pavkriz/zx-uniper/doc/zx-uniper-stm32f7.png

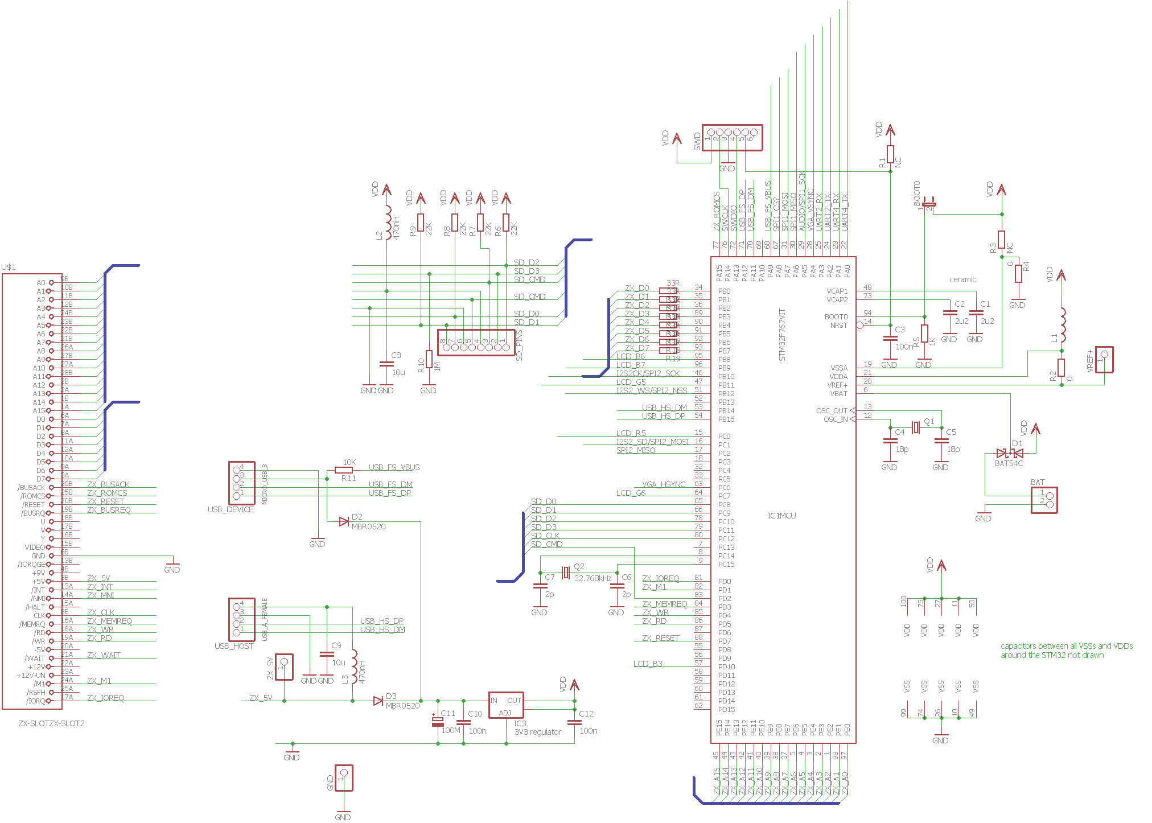
doc/zx-uniper-stm32f7.png
