pavkriz/zx-uniper/doc/zx-uniper-stm32f7.sch

## EAGLE design doc/zx-uniper-stm32f7.sch (2016-10-03)

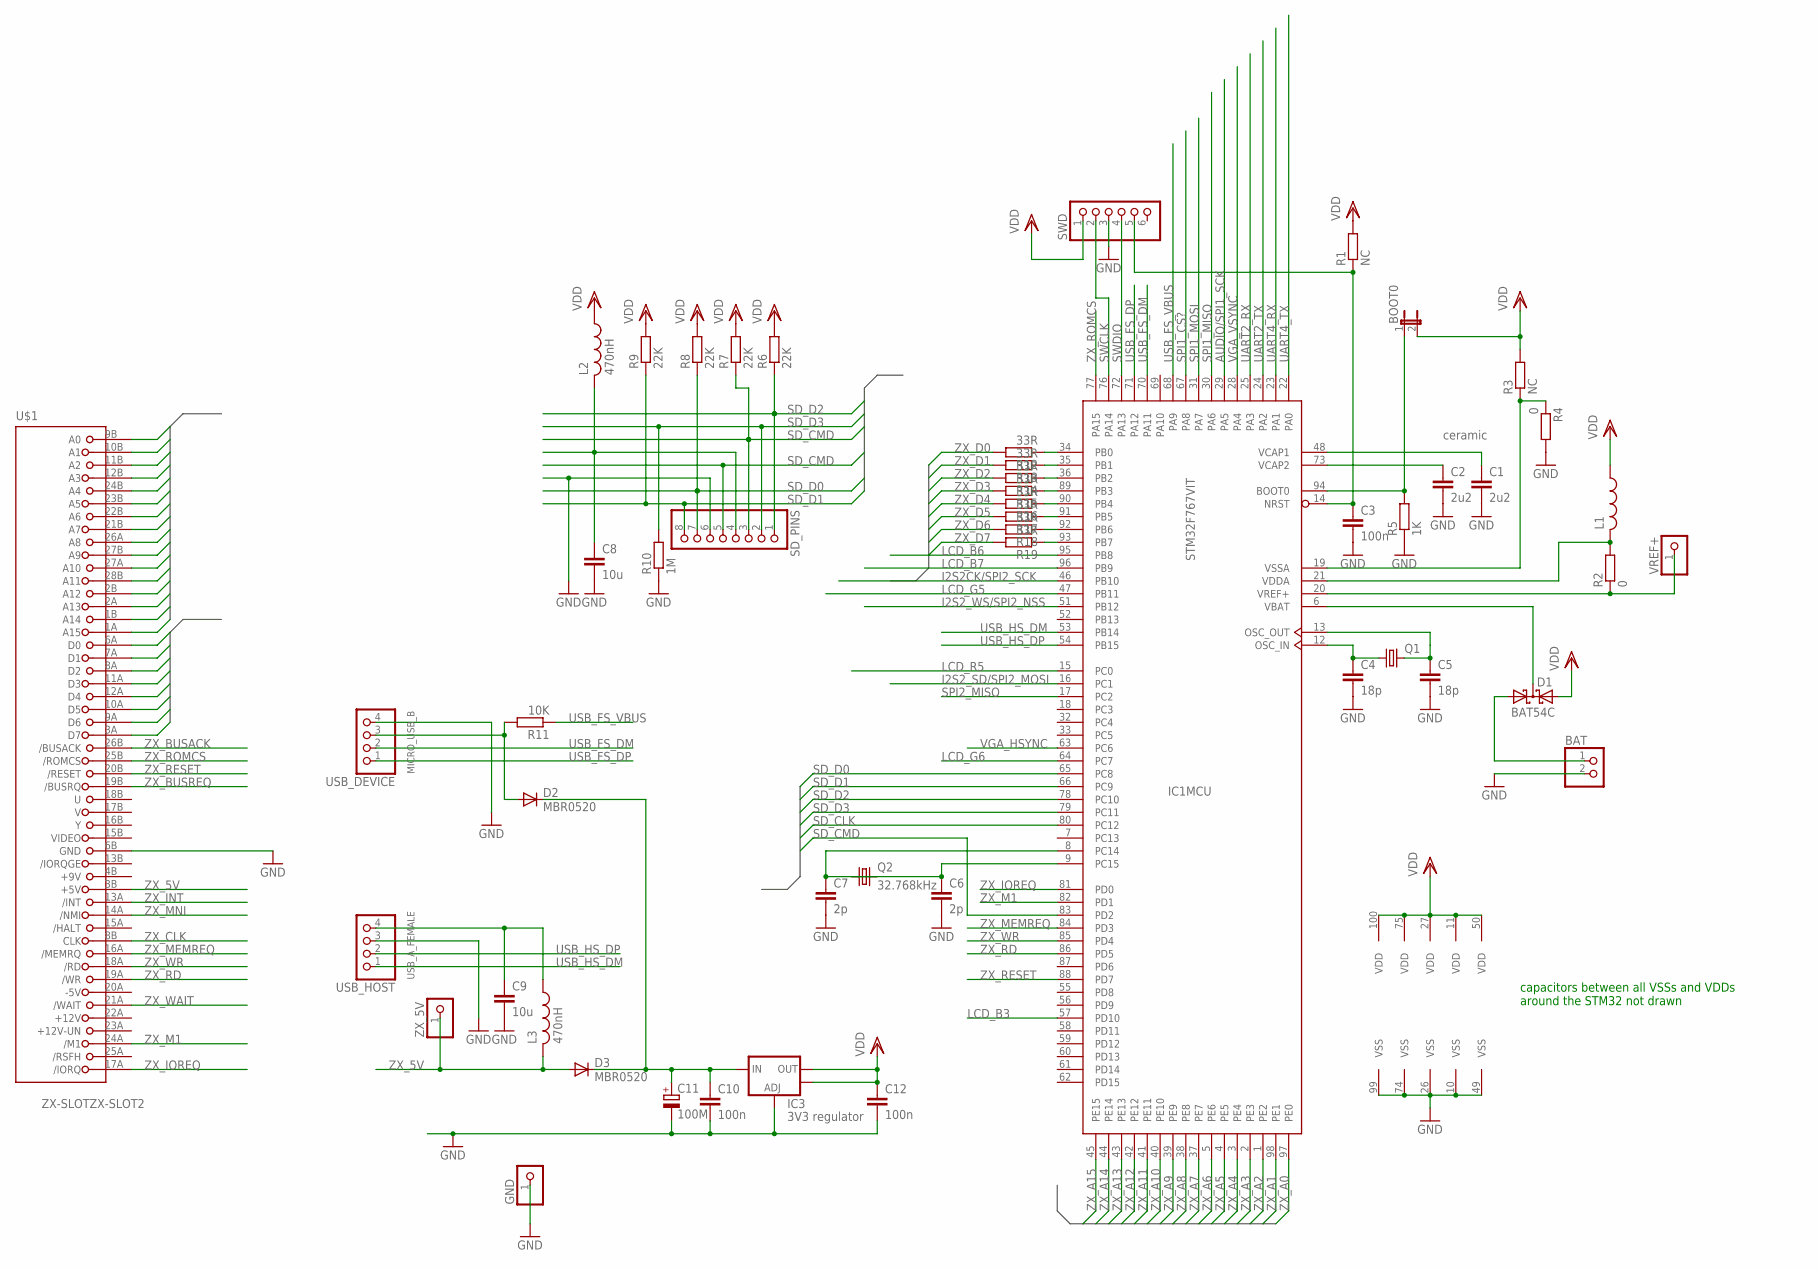
[picture p2: schematic zx-uniper-stm32f7.sch]

Parts:
BAT: PINHD-1X2; 1X02
BOOT0: JP1E; JP1
C1, C2: 2u2; C0504
C3, C10, C12: 100n; C0504
C4, C5: 18p; C0504
C6, C7: 2p; C0504
C8, C9: 10u; C0504
C11: 100M; PANASONIC_E
D1: BAT54C; SOT23
D2, D3: MBR0520; SOD123
GND: PINHD-1X1; 1X01
IC1: STM32F767VIT; LQFP100
IC3: 3V3 regulator; SOT223
L1: L-USL3225P; L3225P
L2, L3: 470nH; L3225P
Q1: CRYSTALSM49; SM49
Q2: 32.768kHz; TC38H
R1, R3: NC; R0805
R2, R4: 0; R0805
R5: 1K; R0805
R6, R7, R8, R9: 22K; R0805
R10: 1M; R0805
R11: 10K; R0805
R12, R13, R14, R15, R16, R17, R18, R19: 33R; R0805
SD_PINS: PINHD-1X8; 1X08
SWD: PINHD-1X6; 1X06
U$1: ZX-SLOTZX-SLOT2; ZXCONECT2
USB_DEVICE: PINHD-1X4; 1X04
USB_HOST: PINHD-1X4; 1X04
VREF+: PINHD-1X1; 1X01
ZX_5V: PINHD-1X1; 1X01

Connections:
AUDIO/SPI1_SCK: IC1.29 (PA5)
GND: BAT.2, C1.2, C2.2, C3.2, C4.2, C5.2, C6.2, C7.2, C8.2, C9.2, C10.2, C11.-, C12.2, GND.1, IC1.10 (VSS), IC1.26 (VSS), IC1.49 (VSS), IC1.74 (VSS), IC1.99 (VSS), IC3.1 (ADJ), R4.2, R5.1, R10.1, SD_PINS.6, SWD.3, U$1.6B (GND), USB_DEVICE.4, USB_HOST.3
I2S2CK/SPI2_SCK: IC1.46 (PB10)
I2S2_SD/SPI2_MOSI: IC1.16 (PC1)
I2S2_WS/SPI2_NSS: IC1.51 (PB12)
LCD_B3: IC1.57 (PD10)
LCD_B6: IC1.95 (PB8)
LCD_B7: IC1.96 (PB9)
LCD_G5: IC1.47 (PB11)
LCD_G6: IC1.64 (PC7)
LCD_R5: IC1.15 (PC0)
unnamed: IC1.20 (VREF+), R2.1, VREF+.1
unnamed: IC1.21 (VDDA), L1.2, R2.2
unnamed: C1.1, IC1.48 (VCAP1)
unnamed: C2.1, IC1.73 (VCAP2)
unnamed: IC1.19 (VSSA), R3.1, R4.1
unnamed: BOOT0.1, IC1.94 (BOOT0), R5.2
unnamed: C4.1, IC1.12 (OSC_IN), Q1.1
unnamed: C5.1, IC1.13 (OSC_OUT), Q1.2
unnamed: C6.1, IC1.9 (PC15), Q2.1
unnamed: C7.1, IC1.8 (PC14), Q2.2
unnamed: D1.3 (CC), IC1.6 (VBAT)
unnamed: BAT.1, D1.1 (A1)
unnamed: C8.1, L2.2, SD_PINS.4
unnamed: C10.1, C11.+, D2.C, D3.C, IC3.3 (IN)
unnamed: IC1.34 (PB0), R12.1
unnamed: IC1.35 (PB1), R13.1
unnamed: IC1.36 (PB2), R14.1
unnamed: IC1.89 (PB3), R15.1
unnamed: IC1.90 (PB4), R16.1
unnamed: IC1.91 (PB5), R17.1
unnamed: IC1.92 (PB6), R18.1
unnamed: IC1.93 (PB7), R19.1
NRST: C3.1, IC1.14 (NRST), R1.1, SWD.5
SD_CLK: IC1.80 (PC12), SD_PINS.5
SD_CMD: IC1.83 (PD2), R7.1, SD_PINS.3
SD_D0: IC1.65 (PC8), R8.1, SD_PINS.7
SD_D1: IC1.66 (PC9), R9.1, SD_PINS.8
SD_D2: IC1.78 (PC10), R6.1, SD_PINS.1
SD_D3: IC1.79 (PC11), R10.2, SD_PINS.2
SPI1_CS?: IC1.67 (PA8)
SPI1_MISO: IC1.30 (PA6)
SPI1_MOSI: IC1.31 (PA7)
SPI2_MISO: IC1.17 (PC2)
SWCLK: IC1.76 (PA14), SWD.2
SWDIO: IC1.72 (PA13), SWD.4
UART2_RX: IC1.25 (PA3)
UART2_TX: IC1.24 (PA2)
UART4_RX: IC1.23 (PA1)
UART4_TX: IC1.22 (PA0)
USB0_VBUS_RAW: D2.A, R11.2, USB_DEVICE.3
USB_FS_DM: IC1.70 (PA11), USB_DEVICE.2
USB_FS_DP: IC1.71 (PA12), USB_DEVICE.1
USB_FS_VBUS: IC1.68 (PA9), R11.1
USB_HOST_5V: C9.1, L3.1, USB_HOST.4
USB_HS_DM: IC1.53 (PB14), USB_HOST.1
USB_HS_DP: IC1.54 (PB15), USB_HOST.2
VDD: BOOT0.2, C12.1, D1.2 (A2), IC1.11 (VDD), IC1.27 (VDD), IC1.50 (VDD), IC1.75 (VDD), IC1.100 (VDD), IC3.2 (OUT), IC3.4 (OUT), L1.1, L2.1, R1.2, R3.2, R6.2, R7.2, R8.2, R9.2, SWD.1
VGA_HSYNC: IC1.63 (PC6)
VGA_VSYNC: IC1.28 (PA4)
ZX_5V: D3.A, L3.2, U$1.3B (+5V), ZX_5V.1
ZX_A0: IC1.97 (PE0), U$1.9B (A0)
ZX_A1: IC1.98 (PE1), U$1.10B (A1)
ZX_A2: IC1.1 (PE2), U$1.11B (A2)
ZX_A3: IC1.2 (PE3), U$1.12B (A3)
ZX_A4: IC1.3 (PE4), U$1.24B (A4)
ZX_A5: IC1.4 (PE5), U$1.23B (A5)
ZX_A6: IC1.5 (PE6), U$1.22B (A6)
ZX_A7: IC1.37 (PE7), U$1.21B (A7)
ZX_A8: IC1.38 (PE8), U$1.26A (A8)
ZX_A9: IC1.39 (PE9), U$1.27B (A9)
ZX_A10: IC1.40 (PE10), U$1.27A (A10)
ZX_A11: IC1.41 (PE11), U$1.28B (A11)
ZX_A12: IC1.42 (PE12), U$1.2B (A12)
ZX_A13: IC1.43 (PE13), U$1.2A (A13)
ZX_A14: IC1.44 (PE14), U$1.1B (A14)
ZX_A15: IC1.45 (PE15), U$1.1A (A15)
ZX_BUSACK: U$1.26B (/BUSACK)
ZX_BUSREQ: U$1.19B (/BUSRQ)
ZX_CLK: U$1.8B (CLK)
ZX_D0: R12.2, U$1.6A (D0)
ZX_D1: R13.2, U$1.7A (D1)
ZX_D2: R14.2, U$1.8A (D2)
ZX_D3: R15.2, U$1.11A (D3)
ZX_D4: R16.2, U$1.12A (D4)
ZX_D5: R17.2, U$1.10A (D5)
ZX_D6: R18.2, U$1.9A (D6)
ZX_D7: R19.2, U$1.3A (D7)
ZX_INT: U$1.13A (/INT)
ZX_IOREQ: IC1.81 (PD0), U$1.17A (/IORQ)
ZX_M1: IC1.82 (PD1), U$1.24A (/M1)
ZX_MEMREQ: IC1.84 (PD3), U$1.16A (/MEMRQ)
ZX_MNI: U$1.14A (/NMI)
ZX_RD: IC1.86 (PD5), U$1.19A (/WR)
ZX_RESET: IC1.88 (PD7), U$1.20B (/RESET)
ZX_ROMCS: IC1.77 (PA15), U$1.25B (/ROMCS)
ZX_WAIT: U$1.21A (/WAIT)
ZX_WR: IC1.85 (PD4), U$1.18A (/RD)

Notes on the sheet:
ceramic
MICRO_USB_B
USB_A_FEMALE
capacitors between all VSSs and VDDs around the STM32 not drawn
