pavkriz/zx-uniper/Src/main.c

/**
  ******************************************************************************
  * File Name          : main.c
  * Description        : Main program body
  ******************************************************************************
  *
  * Copyright (c) 2017 STMicroelectronics International N.V. 
  * All rights reserved.
  *
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
  ******************************************************************************
  */
/* Includes ------------------------------------------------------------------*/
#include "main.h"
#include "stm32f7xx_hal.h"
#include "usb_device.h"
#include "usb_host.h"

/* USER CODE BEGIN Includes */

#include <zx_rd_wr_interrupt.h>
#include "op_sniff_loop.h"
#include "stm32f7xx_hal_conf.h"
#include "pintest.h"
#include <stdarg.h>
#include "usb_host.h"
#include "usbh_msc.h"
#include "emu_divide_ports.h"
#include "uniper_splash.h"


/* USER CODE END Includes */


SD_HandleTypeDef hsd1;

UART_HandleTypeDef huart4;
UART_HandleTypeDef huart2;

/* USER CODE BEGIN PV */

#define HANG_LOOP() {HAL_GPIO_WritePin(LED1_GPIO_Port, LED1_Pin, GPIO_PIN_SET); while (1) {}}


/* USER CODE END PV */

void SystemClock_Config(void);
void Error_Handler(void);
static void MX_GPIO_Init(void);
static void MX_UART4_Init(void);
static void MX_SDMMC1_SD_Init(void);
static void MX_USART2_UART_Init(void);
void MX_USB_HOST_Process(void);

/* USER CODE BEGIN PFP */

/* USER CODE END PFP */

/* USER CODE BEGIN 0 */

#define UART_LEN 1
uint8_t UART_Rx_data[UART_LEN];
volatile int rx_timeouts = 0;


/* USER CODE END 0 */

int main(void)
{

  /* MCU Configuration----------------------------------------------------------*/

  /* Reset of all peripherals, Initializes the Flash interface and the Systick. */
  HAL_Init();

  /* Configure the system clock */
  SystemClock_Config();

  /* Initialize all configured peripherals */
  MX_GPIO_Init();
  //MX_USB_DEVICE_Init();
  //MX_UART4_Init();
  //MX_SDMMC1_SD_Init();
  MX_USART2_UART_Init();
  MX_USB_HOST_Init();

  /* Infinite loop */
  /* USER CODE BEGIN WHILE */

  uint8_t host_command_buffer[20];
  uint8_t sector_buffer[1024];
  int p;

  UART2_printf("=========== START ===============\r\n");

  int zx_init_done = 0;

  UART2_printf("zx_init_pins start\r\n");
  zx_init_pins();
  uniper_splash_show_boot();
  UART2_printf("zx_init_pins end\r\n");
  zx_init_done = 1;


  int usb_disk_found = 0;
  int led_status = 0;
  // wait for USB disk while flashing LED
  while (!usb_disk_found) {
	  HAL_Delay(5);
	  if (GetUsbHostAppliState() == APPLICATION_READY) {
		  usb_disk_found = 1;
	  } else {
		  led_status = !led_status;
		  if (led_status) {
			  HAL_GPIO_WritePin(LED1_GPIO_Port, LED1_Pin, GPIO_PIN_SET);
		  } else {
			  HAL_GPIO_WritePin(LED1_GPIO_Port, LED1_Pin, GPIO_PIN_RESET);
		  }
	  }
	  MX_USB_HOST_Process();
  }

  HAL_GPIO_WritePin(LED1_GPIO_Port, LED1_Pin, GPIO_PIN_RESET);


  MSC_LUNTypeDef lunInfo;
  MSC_GetLUN0Info(&lunInfo);
  UART2_printf("USB block_number=%d, block_size=%d\r\n", lunInfo.capacity.block_nbr, lunInfo.capacity.block_size);

  int startTick = HAL_GetTick();

  emu_wait_until_boot_done();

  emu_default_start();

  while (1)
  {

	  emu_divide_ports_handle_main_loop();

  /* USER CODE END WHILE */
    MX_USB_HOST_Process();

  /* USER CODE BEGIN 3 */
	  	// __WFI();


  }
  /* USER CODE END 3 */

}

/** System Clock Configuration
*/
void SystemClock_Config(void)
{

  RCC_OscInitTypeDef RCC_OscInitStruct;
  RCC_ClkInitTypeDef RCC_ClkInitStruct;
  RCC_PeriphCLKInitTypeDef PeriphClkInitStruct;

    /**Configure the main internal regulator output voltage 
    */
  __HAL_RCC_PWR_CLK_ENABLE();

  __HAL_PWR_VOLTAGESCALING_CONFIG(PWR_REGULATOR_VOLTAGE_SCALE1);

    /**Initializes the CPU, AHB and APB busses clocks 
    */
  RCC_OscInitStruct.OscillatorType = RCC_OSCILLATORTYPE_HSI|RCC_OSCILLATORTYPE_HSE;
  RCC_OscInitStruct.HSEState = RCC_HSE_ON;
  RCC_OscInitStruct.HSIState = RCC_HSI_ON;
  RCC_OscInitStruct.HSICalibrationValue = 16;
  RCC_OscInitStruct.PLL.PLLState = RCC_PLL_ON;
  RCC_OscInitStruct.PLL.PLLSource = RCC_PLLSOURCE_HSE;
  RCC_OscInitStruct.PLL.PLLM = 4;
  RCC_OscInitStruct.PLL.PLLN = 216;
  RCC_OscInitStruct.PLL.PLLP = RCC_PLLP_DIV2;
  RCC_OscInitStruct.PLL.PLLQ = 9;
  if (HAL_RCC_OscConfig(&RCC_OscInitStruct) != HAL_OK)
  {
    Error_Handler();
  }

    /**Activate the Over-Drive mode 
    */
  if (HAL_PWREx_EnableOverDrive() != HAL_OK)
  {
    Error_Handler();
  }

    /**Initializes the CPU, AHB and APB busses clocks 
    */
  RCC_ClkInitStruct.ClockType = RCC_CLOCKTYPE_HCLK|RCC_CLOCKTYPE_SYSCLK
                              |RCC_CLOCKTYPE_PCLK1|RCC_CLOCKTYPE_PCLK2;
  RCC_ClkInitStruct.SYSCLKSource = RCC_SYSCLKSOURCE_PLLCLK;
  RCC_ClkInitStruct.AHBCLKDivider = RCC_SYSCLK_DIV1;
  RCC_ClkInitStruct.APB1CLKDivider = RCC_HCLK_DIV4;
  RCC_ClkInitStruct.APB2CLKDivider = RCC_HCLK_DIV2;

  if (HAL_RCC_ClockConfig(&RCC_ClkInitStruct, FLASH_LATENCY_7) != HAL_OK)
  {
    Error_Handler();
  }

  PeriphClkInitStruct.PeriphClockSelection = RCC_PERIPHCLK_USART2|RCC_PERIPHCLK_UART4
                              |RCC_PERIPHCLK_SDMMC1|RCC_PERIPHCLK_CLK48;
  PeriphClkInitStruct.PLLSAI.PLLSAIN = 96;
  PeriphClkInitStruct.PLLSAI.PLLSAIR = 2;
  PeriphClkInitStruct.PLLSAI.PLLSAIQ = 2;
  PeriphClkInitStruct.PLLSAI.PLLSAIP = RCC_PLLSAIP_DIV4;
  PeriphClkInitStruct.PLLSAIDivQ = 1;
  PeriphClkInitStruct.PLLSAIDivR = RCC_PLLSAIDIVR_2;
  PeriphClkInitStruct.Usart2ClockSelection = RCC_USART2CLKSOURCE_HSI;
  PeriphClkInitStruct.Uart4ClockSelection = RCC_UART4CLKSOURCE_HSI;
  PeriphClkInitStruct.Clk48ClockSelection = RCC_CLK48SOURCE_PLLSAIP;
  PeriphClkInitStruct.Sdmmc1ClockSelection = RCC_SDMMC1CLKSOURCE_CLK48;
  if (HAL_RCCEx_PeriphCLKConfig(&PeriphClkInitStruct) != HAL_OK)
  {
    Error_Handler();
  }

    /**Configure the Systick interrupt time 
    */
  HAL_SYSTICK_Config(HAL_RCC_GetHCLKFreq()/1000);

    /**Configure the Systick 
    */
  HAL_SYSTICK_CLKSourceConfig(SYSTICK_CLKSOURCE_HCLK);

  /* SysTick_IRQn interrupt configuration */
  HAL_NVIC_SetPriority(SysTick_IRQn, 1, 0);
}

/* SDMMC1 init function */
static void MX_SDMMC1_SD_Init(void)
{

  hsd1.Instance = SDMMC1;
  hsd1.Init.ClockEdge = SDMMC_CLOCK_EDGE_RISING;
  hsd1.Init.ClockBypass = SDMMC_CLOCK_BYPASS_DISABLE;
  hsd1.Init.ClockPowerSave = SDMMC_CLOCK_POWER_SAVE_DISABLE;
  hsd1.Init.BusWide = SDMMC_BUS_WIDE_1B;
  hsd1.Init.HardwareFlowControl = SDMMC_HARDWARE_FLOW_CONTROL_DISABLE;
  hsd1.Init.ClockDiv = 0;
  if (HAL_SD_Init(&hsd1) != HAL_OK)
  {
    Error_Handler();
  }

  HAL_SD_ConfigWideBusOperation(&hsd1, SDMMC_BUS_WIDE_4B);

}

/* UART4 init function */
static void MX_UART4_Init(void)
{

  huart4.Instance = UART4;
  huart4.Init.BaudRate = 115200;
  huart4.Init.WordLength = UART_WORDLENGTH_7B;
  huart4.Init.StopBits = UART_STOPBITS_1;
  huart4.Init.Parity = UART_PARITY_NONE;
  huart4.Init.Mode = UART_MODE_TX_RX;
  huart4.Init.HwFlowCtl = UART_HWCONTROL_NONE;
  huart4.Init.OverSampling = UART_OVERSAMPLING_16;
  huart4.Init.OneBitSampling = UART_ONE_BIT_SAMPLE_DISABLE;
  huart4.AdvancedInit.AdvFeatureInit = UART_ADVFEATURE_NO_INIT;
  if (HAL_UART_Init(&huart4) != HAL_OK)
  {
    Error_Handler();
  }

}

/* USART2 init function */
static void MX_USART2_UART_Init(void)
{

  huart2.Instance = USART2;
  huart2.Init.BaudRate = 115200;
  huart2.Init.WordLength = UART_WORDLENGTH_8B;
  huart2.Init.StopBits = UART_STOPBITS_1;
  huart2.Init.Parity = UART_PARITY_NONE;
  huart2.Init.Mode = UART_MODE_TX_RX;
  huart2.Init.HwFlowCtl = UART_HWCONTROL_NONE;
  huart2.Init.OverSampling = UART_OVERSAMPLING_16;
  huart2.Init.OneBitSampling = UART_ONE_BIT_SAMPLE_DISABLE;
  huart2.AdvancedInit.AdvFeatureInit = UART_ADVFEATURE_NO_INIT;
  if (HAL_UART_Init(&huart2) != HAL_OK)
  {
    Error_Handler();
  }

}

/** Configure pins as 
        * Analog 
        * Input 
        * Output
        * EVENT_OUT
        * EXTI
*/
static void MX_GPIO_Init(void)
{

  GPIO_InitTypeDef GPIO_InitStruct;

  /* GPIO Ports Clock Enable */
  __HAL_RCC_GPIOE_CLK_ENABLE();
  __HAL_RCC_GPIOH_CLK_ENABLE();
  __HAL_RCC_GPIOA_CLK_ENABLE();
  __HAL_RCC_GPIOB_CLK_ENABLE();
  __HAL_RCC_GPIOD_CLK_ENABLE();
  __HAL_RCC_GPIOC_CLK_ENABLE();

  /*Configure GPIO pin Output Level */
  HAL_GPIO_WritePin(LED1_GPIO_Port, LED1_Pin, GPIO_PIN_RESET);

  /*Configure GPIO pins : ZX_A2_Pin ZX_A3_Pin ZX_A4_Pin ZX_A5_Pin 
                           ZX_A6_Pin ZX_A7_Pin ZX_A8_Pin ZX_A9_Pin 
                           ZX_A10_Pin ZX_A11_Pin ZX_A12_Pin ZX_A13_Pin 
                           ZX_A14_Pin ZX_A15_Pin ZX_A0_Pin ZX_A1_Pin */
  GPIO_InitStruct.Pin = ZX_A2_Pin|ZX_A3_Pin|ZX_A4_Pin|ZX_A5_Pin 
                          |ZX_A6_Pin|ZX_A7_Pin|ZX_A8_Pin|ZX_A9_Pin 
                          |ZX_A10_Pin|ZX_A11_Pin|ZX_A12_Pin|ZX_A13_Pin 
                          |ZX_A14_Pin|ZX_A15_Pin|ZX_A0_Pin|ZX_A1_Pin;
  GPIO_InitStruct.Mode = GPIO_MODE_INPUT;
  GPIO_InitStruct.Pull = GPIO_NOPULL;
  HAL_GPIO_Init(GPIOE, &GPIO_InitStruct);

  /*Configure GPIO pins : ZX_D0_Pin ZX_D1_Pin ZX_D2_Pin ZX_D3_Pin 
                           ZX_D4_Pin ZX_D5_Pin ZX_D6_Pin ZX_D7_Pin */
  GPIO_InitStruct.Pin = ZX_D0_Pin|ZX_D1_Pin|ZX_D2_Pin|ZX_D3_Pin 
                          |ZX_D4_Pin|ZX_D5_Pin|ZX_D6_Pin|ZX_D7_Pin;
  GPIO_InitStruct.Mode = GPIO_MODE_INPUT;
  GPIO_InitStruct.Pull = GPIO_NOPULL;
  HAL_GPIO_Init(GPIOB, &GPIO_InitStruct);

  /*Configure GPIO pins : ZX_A15_B_Pin ZX_RESET_Pin ZX_IOREQ_Pin ZX_M1_Pin 
                           ZX_MEMREQ_Pin ZX_A13_B_Pin ZX_A14_B_Pin */
  GPIO_InitStruct.Pin = ZX_A15_B_Pin|ZX_RESET_Pin|ZX_IOREQ_Pin|ZX_M1_Pin 
                          |ZX_MEMREQ_Pin|ZX_A13_B_Pin|ZX_A14_B_Pin;
  GPIO_InitStruct.Mode = GPIO_MODE_INPUT;
  GPIO_InitStruct.Pull = GPIO_NOPULL;
  HAL_GPIO_Init(GPIOD, &GPIO_InitStruct);

  /*Configure GPIO pin : LED1_Pin */
  GPIO_InitStruct.Pin = LED1_Pin;
  GPIO_InitStruct.Mode = GPIO_MODE_OUTPUT_PP;
  GPIO_InitStruct.Pull = GPIO_NOPULL;
  GPIO_InitStruct.Speed = GPIO_SPEED_FREQ_LOW;
  HAL_GPIO_Init(LED1_GPIO_Port, &GPIO_InitStruct);

  /*Configure GPIO pins : ZX_WAIT_Pin ZX_ROMCS_Pin */
  GPIO_InitStruct.Pin = ZX_WAIT_Pin|ZX_ROMCS_Pin;
  GPIO_InitStruct.Mode = GPIO_MODE_INPUT;
  GPIO_InitStruct.Pull = GPIO_NOPULL;
  HAL_GPIO_Init(GPIOA, &GPIO_InitStruct);

  /*Configure GPIO pins : ZX_WR_Pin ZX_RD_Pin */
  GPIO_InitStruct.Pin = ZX_WR_Pin|ZX_RD_Pin;
  GPIO_InitStruct.Mode = GPIO_MODE_IT_FALLING;
  GPIO_InitStruct.Pull = GPIO_NOPULL;
  HAL_GPIO_Init(GPIOD, &GPIO_InitStruct);

}

/* USER CODE BEGIN 4 */

void UART2_printf(const char *fmt, ...) {
	char textbuf[2000]; //string buffer

	va_list args;
	va_start(args, fmt);
	vsprintf(textbuf, fmt, args);
	va_end(args);
	HAL_UART_Transmit(&huart2,textbuf, strlen(textbuf), 500); // ms timeout
}

USBH_UserProcess_My(uint8_t id) {
	UART2_printf("USBH_UserProcess_My %d\r\n", id);
}

/* USER CODE END 4 */
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
