pavkriz/zx-uniper/zx-uniper.ioc

Mcu.UserName=STM32F767VITx
PA0/WKUP.Signal=UART4_TX
PA1.Signal=UART4_RX
PA10.GPIO_Label=ZX_WAIT
PA10.Signal=GPIO_Input
PA11.Signal=USB_OTG_FS_DM
PA12.Signal=USB_OTG_FS_DP
PA13.Signal=SYS_JTMS-SWDIO
PA14.Signal=SYS_JTCK-SWCLK
PA15.GPIO_Label=ZX_ROMCS
PA15.Signal=GPIO_Input
PA2.Signal=USART2_TX
PA3.Signal=USART2_RX
PA8.GPIO_Label=LED1
PA8.Signal=GPIO_Output
PB0.GPIO_Label=ZX_D0
PB0.Signal=GPIO_Input
PB1.GPIO_Label=ZX_D1
PB1.Signal=GPIO_Input
PB14.Signal=USB_OTG_HS_DM
PB15.Signal=USB_OTG_HS_DP
PB2.GPIO_Label=ZX_D2
PB2.Signal=GPIO_Input
PB3.GPIO_Label=ZX_D3
PB3.Signal=GPIO_Input
PB4.GPIO_Label=ZX_D4
PB4.Signal=GPIO_Input
PB5.GPIO_Label=ZX_D5
PB5.Signal=GPIO_Input
PB6.GPIO_Label=ZX_D6
PB6.Signal=GPIO_Input
PB7.GPIO_Label=ZX_D7
PB7.Signal=GPIO_Input
PC10.Signal=SDMMC1_D2
PC11.Signal=SDMMC1_D3
PC12.Signal=SDMMC1_CK
PC8.Signal=SDMMC1_D0
PC9.Signal=SDMMC1_D1
PD0.GPIO_Label=ZX_IOREQ
PD0.Signal=GPIO_Input
PD1.GPIO_Label=ZX_M1
PD1.Signal=GPIO_Input
PD15.GPIO_Label=ZX_RESET
PD15.Signal=GPIO_Input
PD2.Signal=SDMMC1_CMD
PD3.GPIO_Label=ZX_MEMREQ
PD3.Signal=GPIO_Input
PD4.GPIO_Label=ZX_WR
PD4.Signal=GPXTI4
PD5.GPIO_Label=ZX_RD
PD5.Signal=GPXTI5
PD6.GPIO_Label=ZX_A13_B
PD6.Signal=GPIO_Input
PD7.GPIO_Label=ZX_A14_B
PD7.Signal=GPIO_Input
PD8.GPIO_Label=ZX_A15_B
PD8.Signal=GPIO_Input
PE0.GPIO_Label=ZX_A0
PE0.Signal=GPIO_Input
PE1.GPIO_Label=ZX_A1
PE1.Signal=GPIO_Input
PE10.GPIO_Label=ZX_A10
PE10.Signal=GPIO_Input
PE11.GPIO_Label=ZX_A11
PE11.Signal=GPIO_Input
PE12.GPIO_Label=ZX_A12
PE12.Signal=GPIO_Input
PE13.GPIO_Label=ZX_A13
PE13.Signal=GPIO_Input
PE14.GPIO_Label=ZX_A14
PE14.Signal=GPIO_Input
PE15.GPIO_Label=ZX_A15
PE15.Signal=GPIO_Input
PE2.GPIO_Label=ZX_A2
PE2.Signal=GPIO_Input
PE3.GPIO_Label=ZX_A3
PE3.Signal=GPIO_Input
PE4.GPIO_Label=ZX_A4
PE4.Signal=GPIO_Input
PE5.GPIO_Label=ZX_A5
PE5.Signal=GPIO_Input
PE6.GPIO_Label=ZX_A6
PE6.Signal=GPIO_Input
PE7.GPIO_Label=ZX_A7
PE7.Signal=GPIO_Input
PE8.GPIO_Label=ZX_A8
PE8.Signal=GPIO_Input
PE9.GPIO_Label=ZX_A9
PE9.Signal=GPIO_Input
PH0/OSC_IN.Signal=RCC_OSC_IN
PH1/OSC_OUT.Signal=RCC_OSC_OUT
