pavkriz/zx-uniper/Inc/mxconstants.h

/**
  ******************************************************************************
  * File Name          : mxconstants.h
  * Description        : This file contains the common defines of the application
  ******************************************************************************
  *
  * COPYRIGHT(c) 2016 STMicroelectronics
  *
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
  ******************************************************************************
  */
/* Define to prevent recursive inclusion -------------------------------------*/
#ifndef __MXCONSTANT_H
#define __MXCONSTANT_H
  /* Includes ------------------------------------------------------------------*/


#define ZX_A2_Pin GPIO_PIN_2
#define ZX_A2_GPIO_Port GPIOE
#define ZX_A3_Pin GPIO_PIN_3
#define ZX_A3_GPIO_Port GPIOE
#define ZX_A4_Pin GPIO_PIN_4
#define ZX_A4_GPIO_Port GPIOE
#define ZX_A5_Pin GPIO_PIN_5
#define ZX_A5_GPIO_Port GPIOE
#define ZX_A6_Pin GPIO_PIN_6
#define ZX_A6_GPIO_Port GPIOE
#define ZX_D0_Pin GPIO_PIN_0
#define ZX_D0_GPIO_Port GPIOB
#define ZX_D1_Pin GPIO_PIN_1
#define ZX_D1_GPIO_Port GPIOB
#define ZX_D2_Pin GPIO_PIN_2
#define ZX_D2_GPIO_Port GPIOB
#define ZX_A7_Pin GPIO_PIN_7
#define ZX_A7_GPIO_Port GPIOE
#define ZX_A8_Pin GPIO_PIN_8
#define ZX_A8_GPIO_Port GPIOE
#define ZX_A9_Pin GPIO_PIN_9
#define ZX_A9_GPIO_Port GPIOE
#define ZX_A10_Pin GPIO_PIN_10
#define ZX_A10_GPIO_Port GPIOE
#define ZX_A11_Pin GPIO_PIN_11
#define ZX_A11_GPIO_Port GPIOE
#define ZX_A12_Pin GPIO_PIN_12
#define ZX_A12_GPIO_Port GPIOE
#define ZX_A13_Pin GPIO_PIN_13
#define ZX_A13_GPIO_Port GPIOE
#define ZX_A14_Pin GPIO_PIN_14
#define ZX_A14_GPIO_Port GPIOE
#define ZX_A15_Pin GPIO_PIN_15
#define ZX_A15_GPIO_Port GPIOE
#define LED1_Pin GPIO_PIN_8
#define LED1_GPIO_Port GPIOA
#define ZX_WAIT_Pin GPIO_PIN_10
#define ZX_WAIT_GPIO_Port GPIOA
#define ZX_ROMCS_Pin GPIO_PIN_15
#define ZX_ROMCS_GPIO_Port GPIOA
#define ZX_IOREQ_Pin GPIO_PIN_0
#define ZX_IOREQ_GPIO_Port GPIOD
#define ZX_M1_Pin GPIO_PIN_1
#define ZX_M1_GPIO_Port GPIOD
#define ZX_MEMREQ_Pin GPIO_PIN_3
#define ZX_MEMREQ_GPIO_Port GPIOD
#define ZX_WR_Pin GPIO_PIN_4
#define ZX_WR_GPIO_Port GPIOD
#define ZX_RD_Pin GPIO_PIN_5
#define ZX_RD_GPIO_Port GPIOD
#define ZX_RESET_Pin GPIO_PIN_7
#define ZX_RESET_GPIO_Port GPIOD
#define ZX_D3_Pin GPIO_PIN_3
#define ZX_D3_GPIO_Port GPIOB
#define ZX_D4_Pin GPIO_PIN_4
#define ZX_D4_GPIO_Port GPIOB
#define ZX_D5_Pin GPIO_PIN_5
#define ZX_D5_GPIO_Port GPIOB
#define ZX_D6_Pin GPIO_PIN_6
#define ZX_D6_GPIO_Port GPIOB
#define ZX_D7_Pin GPIO_PIN_7
#define ZX_D7_GPIO_Port GPIOB
#define ZX_A0_Pin GPIO_PIN_0
#define ZX_A0_GPIO_Port GPIOE
#define ZX_A1_Pin GPIO_PIN_1
#define ZX_A1_GPIO_Port GPIOE
/**
  * @}
  */ 

/**
  * @}
*/ 

#endif /* __MXCONSTANT_H */
/************************ (C) COPYRIGHT STMicroelectronics *****END OF FILE****/
