pavkriz/zx-uniper/(commit log)

2016-05-03 working memloader, loads screen from virtual device to video RAM
2016-10-03 initial commit of STM32F7 version
2016-10-03 Eagle and PNG schema added
    [zx-uniper-stm32f7.sch]
2016-10-11 Divide over UART2 emulation (read-only, only 1 sector)
    Use pc-tool.groovy on PC, put there correct path to HDF disk image
    [main.c, zx-uniper.ioc, zx_rd_wr_interrupt.c, zx_rd_wr_interrupt.h]
2016-10-12 Speed improvements in UART PC-ARM communication
2016-10-15 Fix: ignore 128k memory mapping port and kempston port
    [zx_rd_wr_interrupt.c]
2016-10-16 Sector_count support, preliminary MAPRAM and CONMEM support (probably not correct yet)
    [main.c, zx_rd_wr_interrupt.c, zx_rd_wr_interrupt.h]
2017-03-02 STM32Cube updated, some pins remapped
2017-03-04 Several fixes after STM32Cube updated, now working
    [emu_divide_ports.c, main.c, zx_rd_wr_interrupt.c]
2017-03-06 Disk write operation fixed
    [emu_divide_ports.c, emu_memory.c, main.c, zx_signals.h]
2017-03-16 Get ATA Identify data (name, size) from USB Mass Storage device
2017-03-16 BSOD screen, fix LBA->CHS calc
    [emu_divide_ports.c, emu_memory.c, emu_memory.h, main.c, uniper_splash.c, uniper_splash.h]
2017-04-01 fix: unversioned files (splash ROM)
    [uniper_splash_common.h, uniper_splash_routines.asm]
